Shayshez/WavePainter/README.md

# WavePainter
Eurorack conversion kit for Wave2 - Dual channel oscilloscope

[Build guide](WavePainter_Build_Guide.pdf)

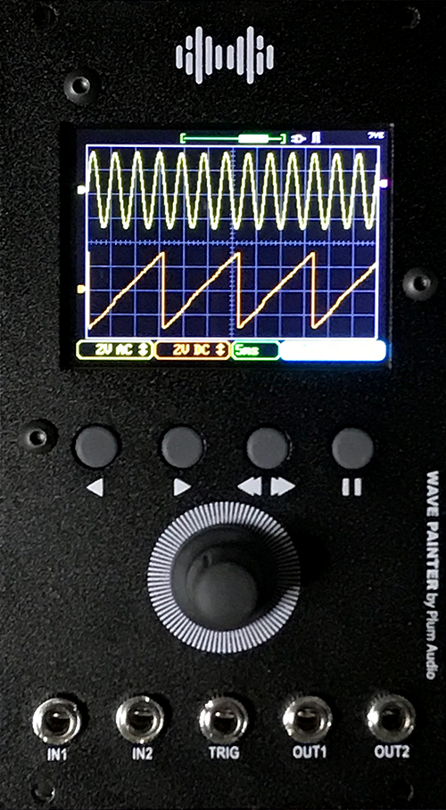
[picture p1: WP2s.png]
WavePainter
