Shayshez/WavePainter/WavePainter_BOM.xlsx

Qty | Value | Device | Package | Parts | Mouser ref | Description
1 |  | WAVE2 Partial kit from Pusherman or DIY kit from JYETEC |  |  | https://pushermanproductions.com/product/wave-painter-dual-channel-oscilloscope-eurorack-partial-kit-14hp/
1 |  | WavePainter conversion PCB from Pusherman
1 |  | WavePainter Panel from Pusherman
 | Resistors
1 | 0R | R-US_R0805 | R0805 | R5 | 603-RC0805FR-130RL | RESISTOR, American symbol
2 | 4.7R | R-US_R1206 | R1206 | R6, R7 | 603-RC1206FR-074R7L | RESISTOR, American symbol
2 | 51R | R-US_R0805 | R0805 | R3, R4 | 603-RC0805JR-7W51RL | RESISTOR, American symbol
2 | 10M | R-US_R0805 | R0805 | R1, R2 | 603-RC0805FR-0710ML | RESISTOR, American symbol
 | Caps
3 | 0.1uF | C-USC0805 | C0805 | C1, C2, C3 | 80-C0805C104J5RAUTO | CAPACITOR, American symbol
3 | 10u | CPOL-USC | PANASONIC_B | C6, C9, C10 | 667-EEE-FK1E100R | POLARIZED CAPACITOR, American symbol
2 | 47u | CPOL-USD | PANASONIC_D | C4, C7 | 667-EEE-FK1V470P | POLARIZED CAPACITOR, American symbol
 | Inductor
1 | 33uH | L-USL3225P | L3225P | L4 | 963-LB3218T330K | INDUCTOR, American symbol
 | Chips
2 | 1N5819HW | DIODE_DIODE-SOD123 | DIODE_SOD123 | D1, D2 | 621-1N5819HW-F | DIODE
1 | R-78E5.0-0.5 | R-78E5.0-0.5 | SIP3 | IC2 | 919-R-78E5.0-0.5 | Innoline R-78xx-0.5 Series Switching Regulators - 0.5A, Low Cost
1 | TL074 | TL074D | SO14 | IC1 | 595-TL074CDR | OP AMP
 | Misc
1 | Pin Headers Male 2.54 - 2pins | PINHEAD 2.54mm 2p |  | J10 | 855-M20-9774046 | Pin Headers 2.54mm - row of 40pins - cut 2 for J10 and 3 for J9
1 | Pin Headers Male 2.54 - 3pins | PINHEAD 2.54mm 3p |  | J9
2 | Pin Headers Male 2.54 - 2X3pins | PINHEAD 2.54mm Dual row of 3p |  | J7, J8 | 649-77313-124-40LF | Pin Headers 2.54mm - dual row of 40pins - cut for J7/J8
1 | Pin Headers male 2.00mm 14 pins (2X7) | Pin Headers 2.00mm |  | J5 | 855-M22-2020705 | WR-PHD 2.00mm Dual Socket Header, 14 Pins=>Code : Con_BTB_SHD_2.00_2_62001421821
3 | Mini Jumper Cover |  |  |  | 855-M7582-05
3 | Black Screw M3 / > 10mm Length |  |  |  | https://www.aliexpress.com/item/32965979997.html | To attach the panel
1 | Standoff Spacer M3 / 8mm Length |  |  |  | https://www.aliexpress.com/item/32800873842.html | Nylon is better
2 | Standoff Spacer M3 / 5mm Length |  |  |  | https://www.aliexpress.com/item/32800873842.html | Nylon is better
2 | M3 / 6mm Length screw |  |  |  | https://www.taydaelectronics.com/m3-stainless-steel-screw-cross-round-head-m3x6mm.html
4 | M3 / 4mm Length screw |  |  |  | https://www.taydaelectronics.com/m3-stainless-steel-screw-cross-round-head-m3x4mm.html | you can cut 6mm Nylon screws
5 | PJ398SM_THONKICONN | PJ398SM_THONKICONN | WQP_PJ398SM | J1, J2, J3, J4, J6 | https://www.thonk.co.uk/shop/thonkiconn/
1 | Power Header 16 pins | POWER_SHROUDED | POWER_16_SHROUDED | J11 | 538-70246-1604
 | For scope bards
1 | Pin Headers female 2.00mm 14 pins (2X7) | Pin Headers socket 2.00mm | for scope main board | J5 | 855-M22-7140742 | WR-PHD 2.00mm Dual Socket Header, 14 Pins=>Code : Con_BTB_SHD_2.00_2_62001421821
1 | PEC11 Encoder | PEC11L-4220F-S0015 | 15PPR / 30 DETENT / SLIM | SW5 | 652-PEC11L4220FS0015 (20mm shaft) or 652-PEC11L4215FS0015 (15mm shaft)
1 | Knob D Shaft for the encoder | Sifam D-shaft 12mm |  |  | https://www.thonk.co.uk/shop/sifam-soft-touch-encoder-knobs/
