Shayshez/WavePainter/Eagle/WavePainter_1.1.brd

## EAGLE design Eagle/WavePainter_1.1.brd (2019-11-15)

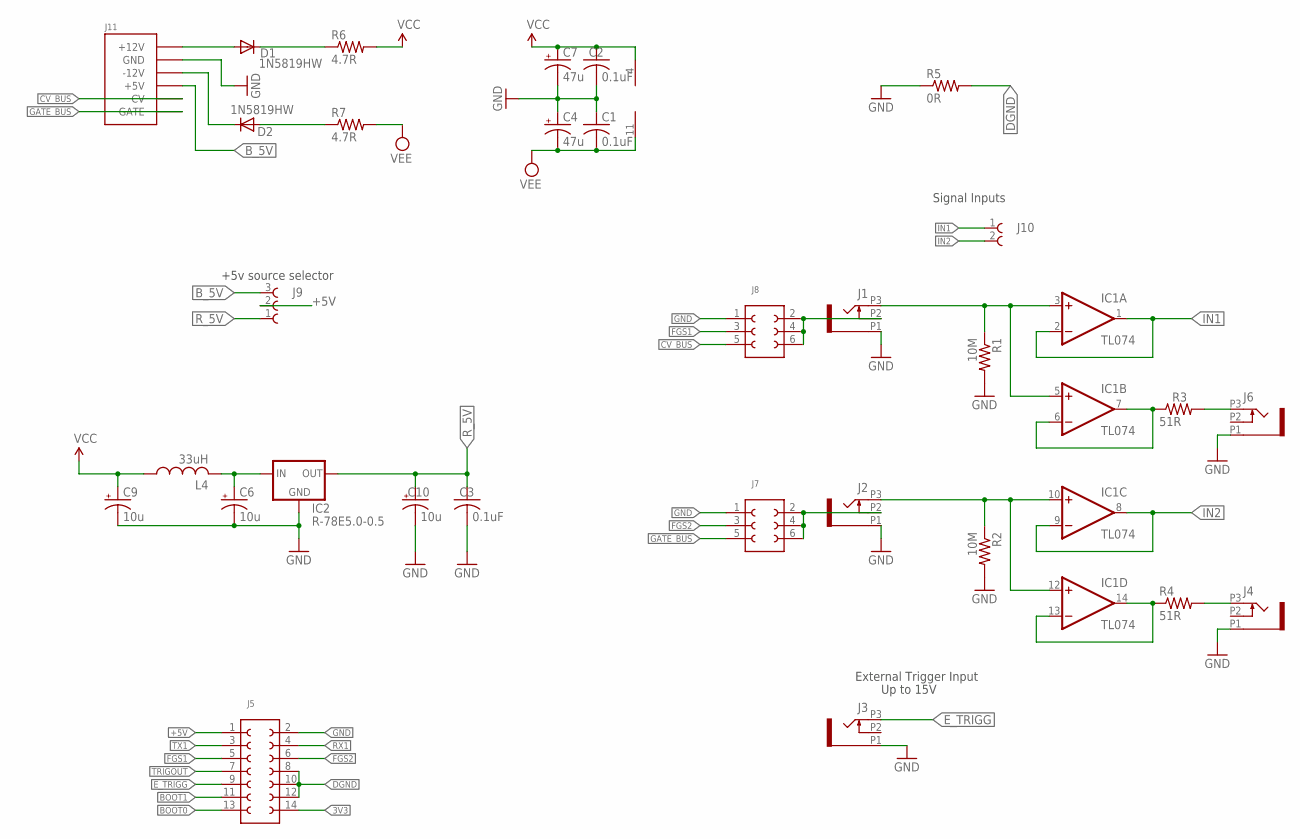
[picture p2: schematic WavePainter_1.1.sch]

Parts:
C1, C2, C3: 0.1uF; C0805
C4, C7: 47u; PANASONIC_D
C6, C9, C10: 10u; PANASONIC_B
D1, D2: 1N5819HW; DIODE_SOD123
IC1: TL074; SO14
IC2: R-78E5.0-0.5; SIP3
J1, J2, J3, J4, J6: OG-PJ301_PJ301_THONKICONN7; OG-PJ301_WQP_PJ_301M7
J5: 62001421821
J7, J8: 61300621121
J9: 61300311121
J10: 61300211821
J11: POWER_SHROUDED_NOTEXT; POWER_16_SHROUDED_NOTEXT
L4: 33uH; L3225P
R1, R2: 10M; R0805
R3, R4: 51R; R0805
R5: 0R; R0805
R6, R7: 4.7R; R1206

Connections:
3V3: J5.14 (8)
+5V: J5.1, J9.2
BOOT0: J5.13 (7)
BOOT1: J5.11 (6)
B_5V: J9.3 (1), J11.11 (+5V), J11.12 (+5V)
CV_BUS: J8.5 (3), J11.13 (CV), J11.14 (CV)
DGND: J5.8 (11), J5.10, J5.12 (9), R5.2
E_TRIGG: J3.P3 (3), J5.9 (5)
FGS1: J5.5 (3), J8.3 (2)
FGS2: J5.6 (12), J7.3 (2)
GATE_BUS: J7.5 (3), J11.15 (GATE), J11.16 (GATE)
GND: C1.1, C2.2, C3.2, C4.+, C6.-, C7.-, C9.-, C10.-, IC2.2 (GND), J1.P1 (1), J2.P1 (1), J3.P1 (1), J4.P1 (1), J5.2 (14), J6.P1 (1), J7.1, J8.1, J11.3 (GND), J11.4 (GND), J11.5 (GND), J11.6 (GND), J11.7 (GND), J11.8 (GND), R1.2, R2.2, R5.1
IN1: IC1.1 (OUT), IC1.2 (-IN), J10.1
IN2: IC1.8 (OUT), IC1.9 (-IN), J10.2
unnamed: IC1.10 (+IN), IC1.12 (+IN), J2.P3 (3), R2.1
unnamed: D2.C, J11.1 (-12V), J11.2 (-12V)
unnamed: C6.+, IC2.1 (IN), L4.2
unnamed: D1.A, J11.9 (+12V), J11.10 (+12V)
unnamed: IC1.3 (+IN), IC1.5 (+IN), J1.P3 (3), R1.1
unnamed: J4.P3 (3), R4.2
unnamed: D1.C, R6.1
unnamed: D2.A, R7.1
unnamed: J6.P3 (3), R3.2
unnamed: IC1.6 (-IN), IC1.7 (OUT), R3.1
unnamed: IC1.13 (-IN), IC1.14 (OUT), R4.1
unnamed: J1.P2 (2), J8.2 (6), J8.4 (5), J8.6 (4)
unnamed: J2.P2 (2), J7.2 (6), J7.4 (5), J7.6 (4)
RX1: J5.4 (13)
R_5V: C3.1, C10.+, IC2.3 (OUT), J9.1 (3)
TRIGOUT: J5.7 (4)
TX1: J5.3 (2)
VCC: C2.1, C7.+, C9.+, IC1.4 (V+), L4.1, R6.2
VEE: C1.2, C4.-, IC1.11 (V-), R7.2

Notes on the sheet:
Signal Inputs
+5v source selector
External Trigger Input
Up to 15V

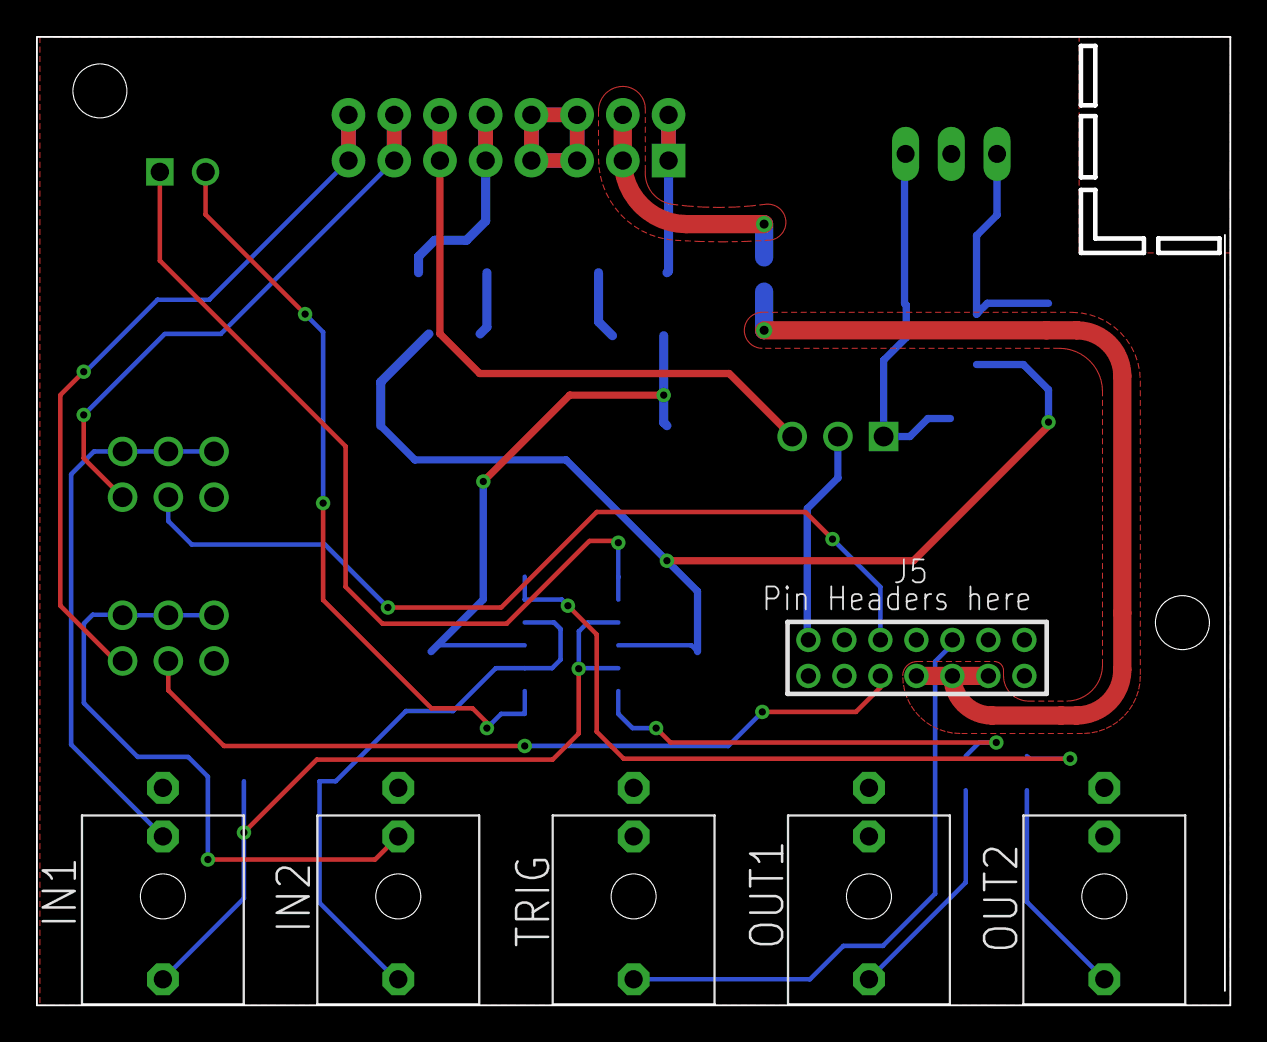
[picture p3: board WavePainter_1.1.brd from above]

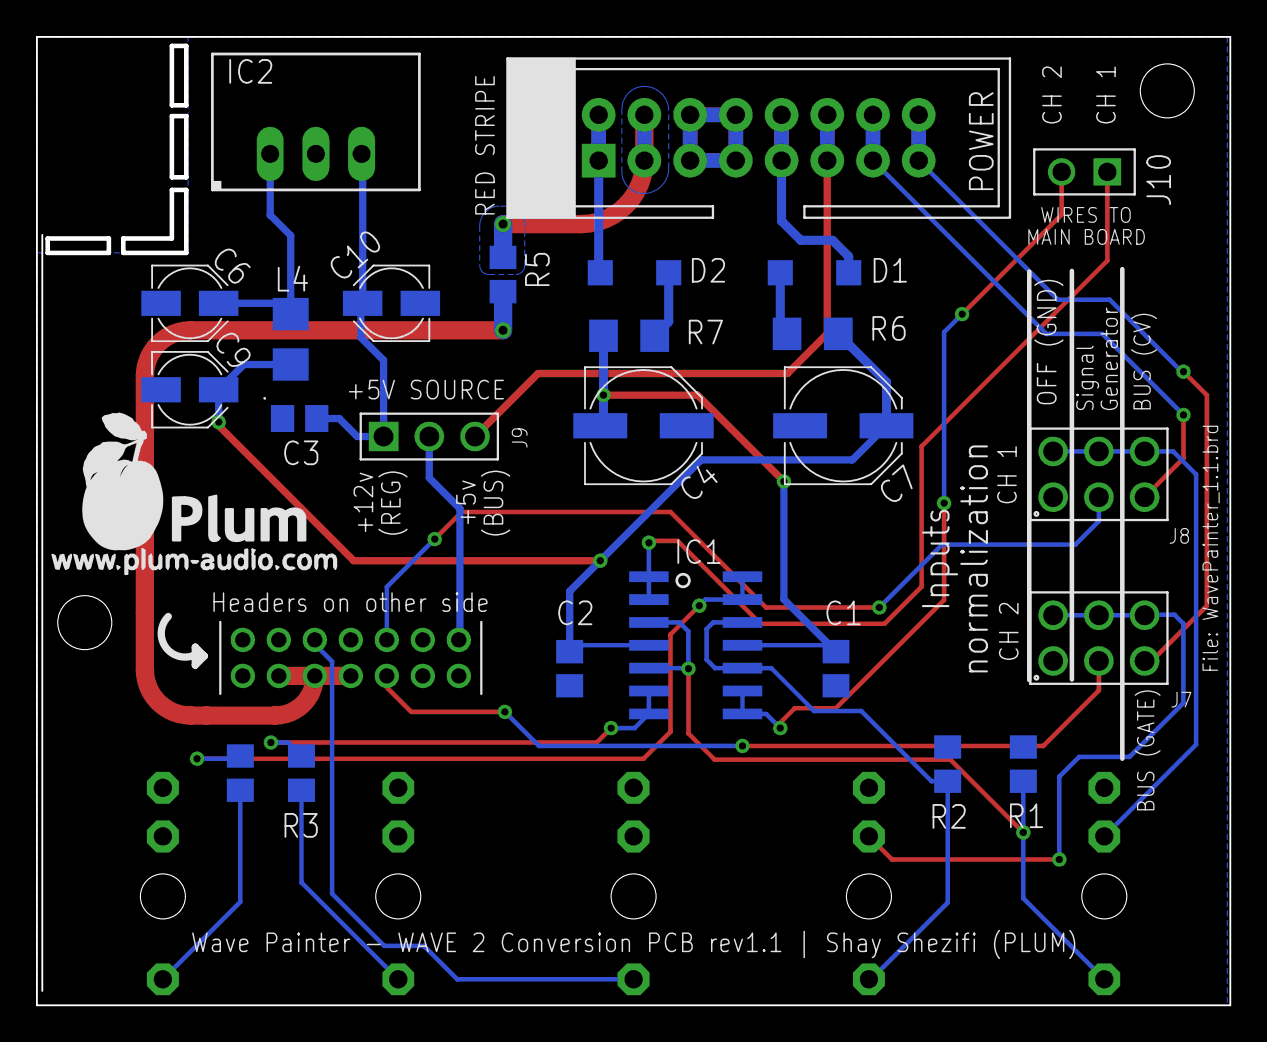
[picture p4: board WavePainter_1.1.brd from below]

Board: 2 copper layers, 66.3 x 53.8 mm, 31 parts (26 on the bottom side), 27 nets.
