Shayshez/WavePainter/WavePainter_Build_Guide.pdf

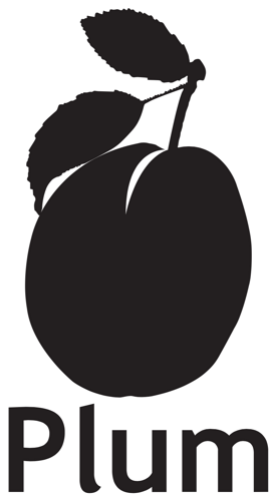
[picture p28: figure]
