Shayshez/WavePainter/(notices)

Notices in the files:
parts and their libraries:
Wurth_Elektronik_Electromechanic_Board_t: Copyright: Würth Elektronik
r-78xx_10: (c) 2015 Samuel Lourenço
